AnthonyPapageo/Datalogger/README.md

# Datalogger
Datalogger with LCD interface

TFE Bachelier, c'était cool Thales !
