AnthonyPapageo/Datalogger/Eagle/DataloggerE7.brd

## EAGLE design Eagle/DataloggerE7.brd (2019-06-06)

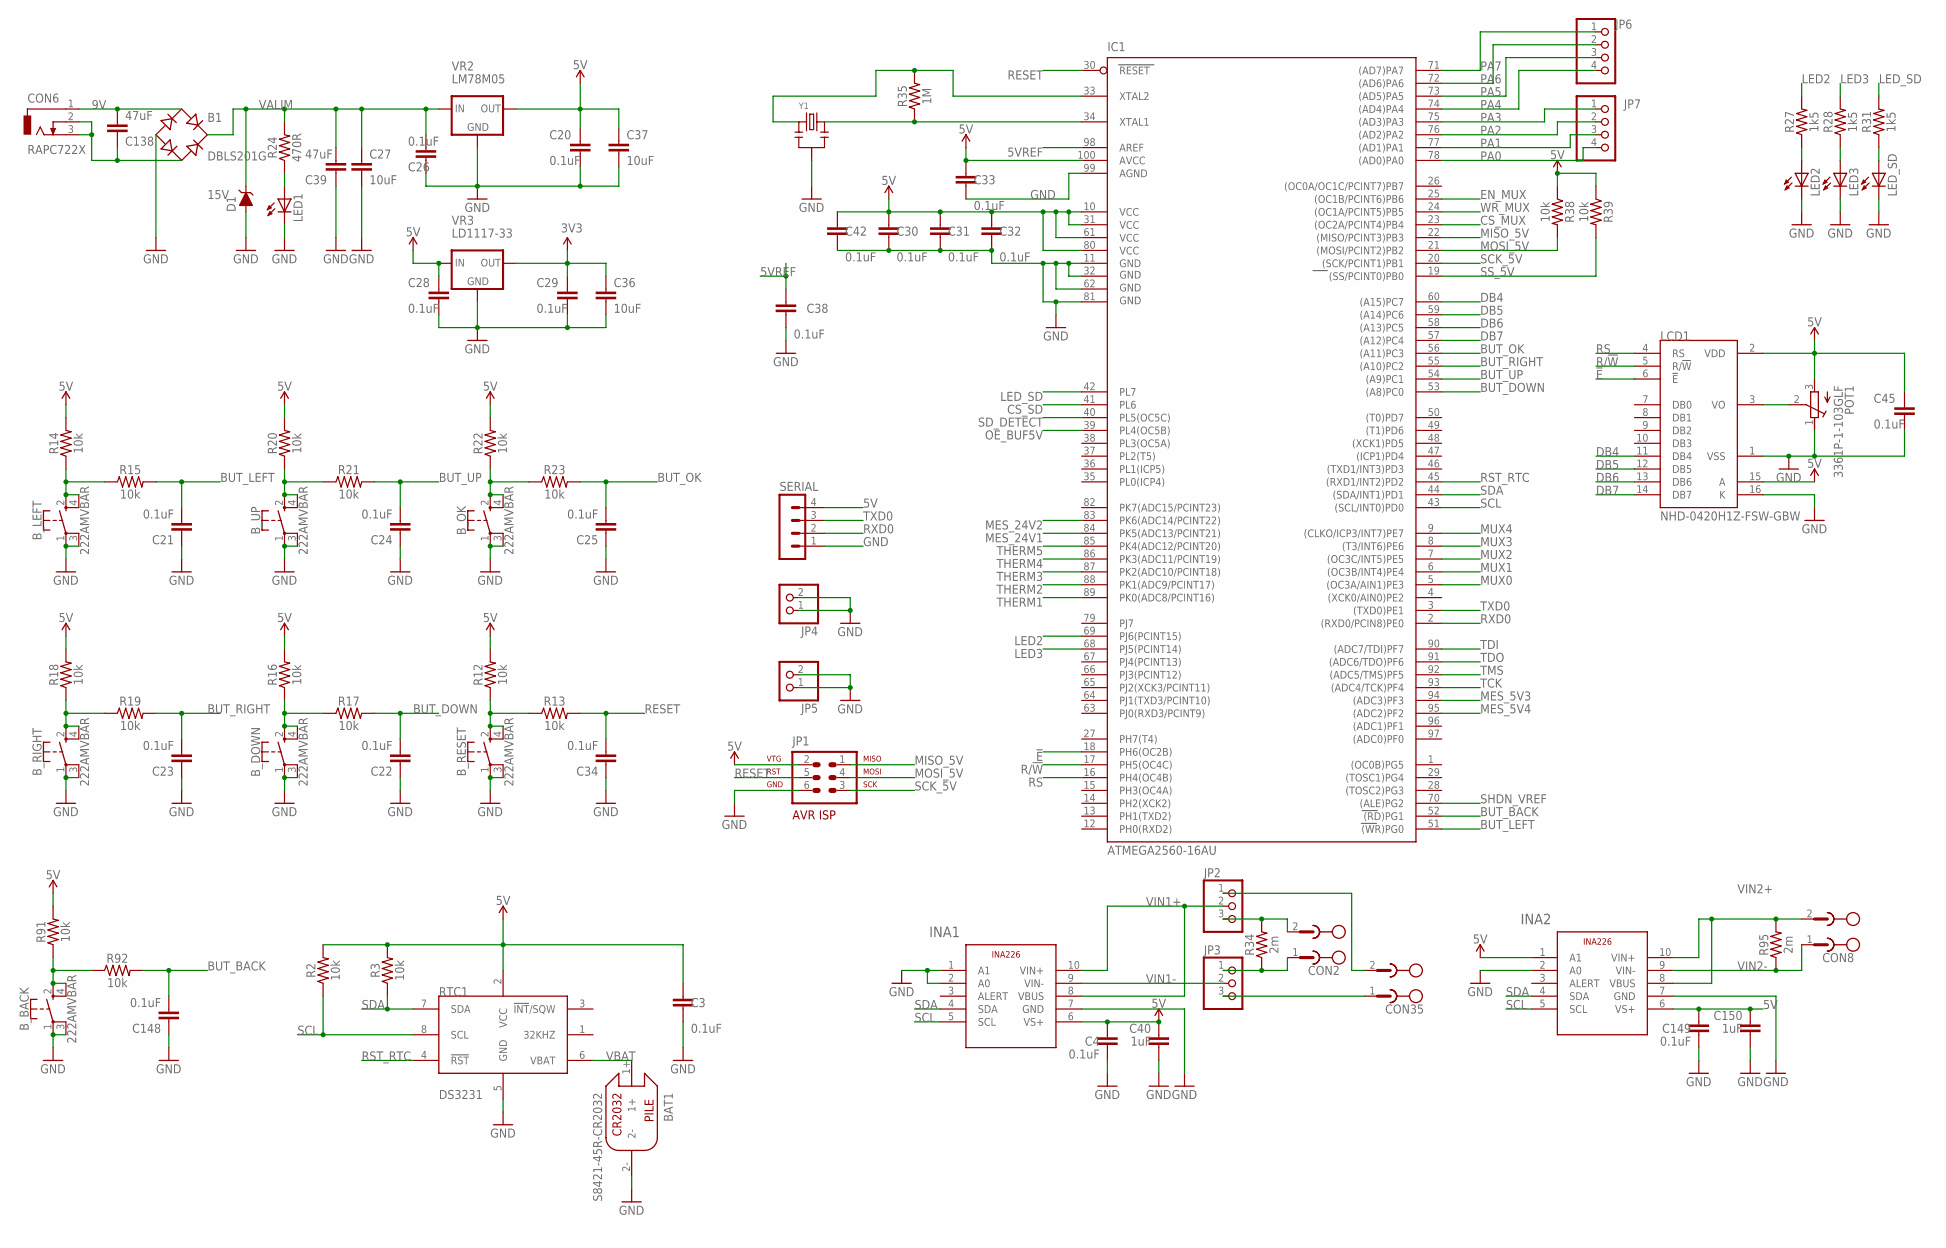
[picture p1: schematic DataloggerE7.sch, sheet 1]

Parts:
B1: DBLS201G; DBS
BAT1: S8421-45R-CR2032
B_BACK: 222AMVBAR; 222AMVBARSWITCH
B_DOWN: 222AMVBAR; 222AMVBARSWITCH
B_LEFT: 222AMVBAR; 222AMVBARSWITCH
B_OK: 222AMVBAR; 222AMVBARSWITCH
B_RESET: 222AMVBAR; 222AMVBARSWITCH
B_RIGHT: 222AMVBAR; 222AMVBARSWITCH
B_UP: 222AMVBAR; 222AMVBARSWITCH
C3, C4, C20, C21, C22, C23, C24, C25, C26, C28, C29, C30, C31, C32, C33, C34, C38, C42, C45, C148, C149: 0.1uF; 0603
C27, C36, C37: 10uF; 1206
C39, C138: 47uF; 1206
C40, C150: 1uF; 0603
CON2, CON8, CON35: CON_PHOENIX_508_2; MSTBV2
CON6: RAPC722X; JACK_RAPC722X
D1: DIODE-ZENER-MMSZ5232BS; SOD-323
IC1: ATMEGA2560-16AU; TQFP100
INA1, INA2: TI-INA226
JP1: AVR-ISP-6
JP2, JP3: PINHD-1X3; 1X03
JP4, JP5: PINHD-1X2; 1X02
JP6, JP7: PINHD-1X4; 1X04
LCD1: NHD-0420H1Z-FSW-GBW; LCD_2X8PINS
LED1, LED2, LED3: LEDSMT1206; 1206
LED_SD: LEDSMT1206; 1206
POT1: 3361P-1-103GLF; TRIMMER_BOURNS_SMD
R2, R3, R12, R13, R14, R15, R16, R17, R18, R19, R20, R21, R22, R23, R38, R39, R91, R92: 10k; 0603
R24: 470R; 1206
R27, R28, R31: 1k5; 0603
R34, R95: 2m; R2010
R35: 1M; 0603
RTC1: DS3231M; SOIC8
SERIAL: MA04-1
VR2: LM78M05; TO-252
VR3: LD1117-33; SOT223-THERMAL
Y1: CSTCE16M0V53-R0; CSTCE_V

Connections:
3V3: C29.1, C36.1, VR3.2 (OUT), VR3.4 (OUT); also elsewhere on the board
5V: C3.1, C4.2, C20.1, C28.1, C30.1, C31.1, C32.1, C33.1, C37.1, C40.2, C42.1, C45.1, C149.2, C150.2, IC1.10 (VCC), IC1.31 (VCC1), IC1.61 (VCC2), IC1.80 (VCC3), IC1.100 (AVCC), INA1.6 (VS+), INA2.1 (A1), INA2.6 (VS+), JP1.2, LCD1.2 (VDD), LCD1.15 (A), POT1.3 (A), R2.2, R3.2, R12.2, R14.2, R16.2, R18.2, R20.2, R22.2, R38.1, R39.1, R91.2, RTC1.2 (VCC), SERIAL.4, VR2.2 (OUT), VR3.3 (IN); also elsewhere on the board
5VREF: C38.1, IC1.98 (AREF); also elsewhere on the board
9V: B1.AC1, C138.1, CON6.1
!E!: IC1.18 (PH6(OC2B)), LCD1.6 (!E)
BUT_BACK: C148.2, IC1.52 ((RD)PG1), R92.2
BUT_DOWN: C22.2, IC1.53 ((A8)PC0), R17.2
BUT_LEFT: C21.2, IC1.51 ((WR)PG0), R15.2
BUT_OK: C25.2, IC1.56 ((A11)PC3), R23.2
BUT_RIGHT: C23.2, IC1.55 ((A10)PC2), R19.2
BUT_UP: C24.2, IC1.54 ((A9)PC1), R21.2
CS_MUX: IC1.23 ((OC2A/PCINT4)PB4); also elsewhere on the board
CS_SD: IC1.41 (PL6); also elsewhere on the board
DB4: IC1.60 ((A15)PC7), LCD1.11 (DB4)
DB5: IC1.59 ((A14)PC6), LCD1.12 (DB5)
DB6: IC1.58 ((A13)PC5), LCD1.13 (DB6)
DB7: IC1.57 ((A12)PC4), LCD1.14 (DB7)
EN_MUX: IC1.25 ((OC1B/PCINT6)PB6); also elsewhere on the board
GND: B1.-, BAT1.2-, B_BACK.1, B_BACK.3 (2), B_DOWN.1, B_DOWN.3 (2), B_LEFT.1, B_LEFT.3 (2), B_OK.1, B_OK.3 (2), B_RESET.1, B_RESET.3 (2), B_RIGHT.1, B_RIGHT.3 (2), B_UP.1, B_UP.3 (2), C3.2, C4.1, C20.2, C21.1, C22.1, C23.1, C24.1, C25.1, C26.2, C27.2, C28.2, C29.2, C30.2, C31.2, C32.2, C33.2, C34.1, C36.2, C37.2, C38.2, C39.2, C40.1, C42.2, C45.2, C148.1, C149.1, C150.1, D1.A, IC1.11 (GND), IC1.32 (GND1), IC1.62 (GND2), IC1.81 (GND3), IC1.99 (AGND), INA1.1 (A1), INA1.2 (A0), INA1.7 (GND), INA2.2 (A0), INA2.7 (GND), JP1.6, JP4.1, JP4.2, JP5.1, JP5.2, LCD1.1 (VSS), LCD1.16 (K), LED1.C, LED2.C, LED3.C, LED_SD.C, POT1.1 (E), RTC1.5 (GND), SERIAL.1, VR2.3 (GND), VR3.1 (GND), Y1.2 (GND); also elsewhere on the board
LED2: IC1.69 (PJ6(PCINT15)), R27.2
LED3: IC1.68 (PJ5(PCINT14)), R28.2
LED_SD: IC1.42 (PL7), R31.2
MES_5V3: IC1.94 ((ADC3)PF3); also elsewhere on the board
MES_5V4: IC1.95 ((ADC2)PF2); also elsewhere on the board
MES_24V1: IC1.84 (PK5(ADC13/PCINT21)); also elsewhere on the board
MES_24V2: IC1.83 (PK6(ADC14/PCINT22)); also elsewhere on the board
MISO_5V: IC1.22 ((MISO/PCINT3)PB3), JP1.1; also elsewhere on the board
MOSI_5V: IC1.21 ((MOSI/PCINT2)PB2), JP1.4, R38.2; also elsewhere on the board
MUX0: IC1.5 ((OC3A/AIN1)PE3); also elsewhere on the board
MUX1: IC1.6 ((OC3B/INT4)PE4); also elsewhere on the board
MUX2: IC1.7 ((OC3C/INT5)PE5); also elsewhere on the board
MUX3: IC1.8 ((T3/INT6)PE6); also elsewhere on the board
MUX4: IC1.9 ((CLKO/ICP3/INT7)PE7); also elsewhere on the board
unnamed: B1.AC2, C138.2, CON6.2, CON6.3
unnamed: B_LEFT.2 (3), B_LEFT.4, R14.1, R15.1
unnamed: B_DOWN.2 (3), B_DOWN.4, R16.1, R17.1
unnamed: B_RIGHT.2 (3), B_RIGHT.4, R18.1, R19.1
unnamed: B_UP.2 (3), B_UP.4, R20.1, R21.1
unnamed: B_OK.2 (3), B_OK.4, R22.1, R23.1
unnamed: B_RESET.2 (3), B_RESET.4, R12.1, R13.1
unnamed: LED1.A, R24.1
unnamed: LCD1.3 (VO), POT1.2 (S)
unnamed: LED_SD.A, R31.1
unnamed: LED2.A, R27.1
unnamed: CON2.1, JP3.1, R34.1
unnamed: CON2.2, JP2.3, R34.2
unnamed: CON35.2, JP2.1
unnamed: CON35.1, JP3.3
unnamed: LED3.A, R28.1
unnamed: B_BACK.2 (3), B_BACK.4, R91.1, R92.1
OE_BUF5V: IC1.39 (PL4(OC5B)); also elsewhere on the board
PA0: IC1.78 ((AD0)PA0), JP7.4
PA1: IC1.77 ((AD1)PA1), JP7.3
PA2: IC1.76 ((AD2)PA2), JP7.2
PA3: IC1.75 ((AD3)PA3), JP7.1
PA4: IC1.74 ((AD4)PA4), JP6.4
PA5: IC1.73 ((AD5)PA5), JP6.3
PA6: IC1.72 ((AD6)PA6), JP6.2
PA7: IC1.71 ((AD7)PA7), JP6.1
R/!W!: IC1.17 (PH5(OC4C)), LCD1.5 (R/!W)
RESET: C34.2, IC1.30 (RESET), JP1.5, R13.2; also elsewhere on the board
RS: IC1.16 (PH4(OC4B)), LCD1.4 (RS)
RST_RTC: IC1.45 ((RXD1/INT2)PD2), RTC1.4 (!RST!)
RXD0: IC1.2 ((RXD0/PCIN8)PE0), SERIAL.2
SCK_5V: IC1.20 ((SCK/PCINT1)PB1), JP1.3; also elsewhere on the board
SCL: IC1.43 ((SCL/INT0)PD0), INA1.5 (SCL), INA2.5 (SCL), R2.1, RTC1.8 (SCL)
SDA: IC1.44 ((SDA/INT1)PD1), INA1.4 (SDA), INA2.4 (SDA), R3.1, RTC1.7 (SDA)
SD_DETECT: IC1.40 (PL5(OC5C)); also elsewhere on the board
SHDN_VREF: IC1.70 ((ALE)PG2); also elsewhere on the board
SS_5V: IC1.19 ((SS/PCINT0)PB0), R39.2; also elsewhere on the board
TCK: IC1.93 ((ADC4/TCK)PF4); also elsewhere on the board
TDI: IC1.90 ((ADC7/TDI)PF7); also elsewhere on the board
TDO: IC1.91 ((ADC6/TDO)PF6); also elsewhere on the board
THERM1: IC1.89 (PK0(ADC8/PCINT16)); also elsewhere on the board
THERM2: IC1.88 (PK1(ADC9/PCINT17)); also elsewhere on the board
THERM3: IC1.87 (PK2(ADC10/PCINT18)); also elsewhere on the board
THERM4: IC1.86 (PK3(ADC11/PCINT19)); also elsewhere on the board
THERM5: IC1.85 (PK4(ADC12/PCINT20)); also elsewhere on the board
TMS: IC1.92 ((ADC5/TMS)PF5); also elsewhere on the board
TXD0: IC1.3 ((TXD0)PE1), SERIAL.3
VALIM: B1.+, C26.1, C27.1, C39.1, D1.C, R24.2, VR2.1 (IN); also elsewhere on the board
VBAT: BAT1.1+, RTC1.6 (VBAT)
VIN1+: INA1.8 (VBUS), INA1.10 (VIN+), JP2.2
VIN1-: INA1.9 (VIN-), JP3.2
VIN2+: CON8.2, INA2.8 (VBUS), INA2.10 (VIN+), R95.2
VIN2-: CON8.1, INA2.9 (VIN-), R95.1
WR_MUX: IC1.24 ((OC1A/PCINT5)PB5); also elsewhere on the board
XTAL1: IC1.34 (XTAL1), R35.1, Y1.3
XTAL2: IC1.33 (XTAL2), R35.2, Y1.1

Notes on the sheet:
15V

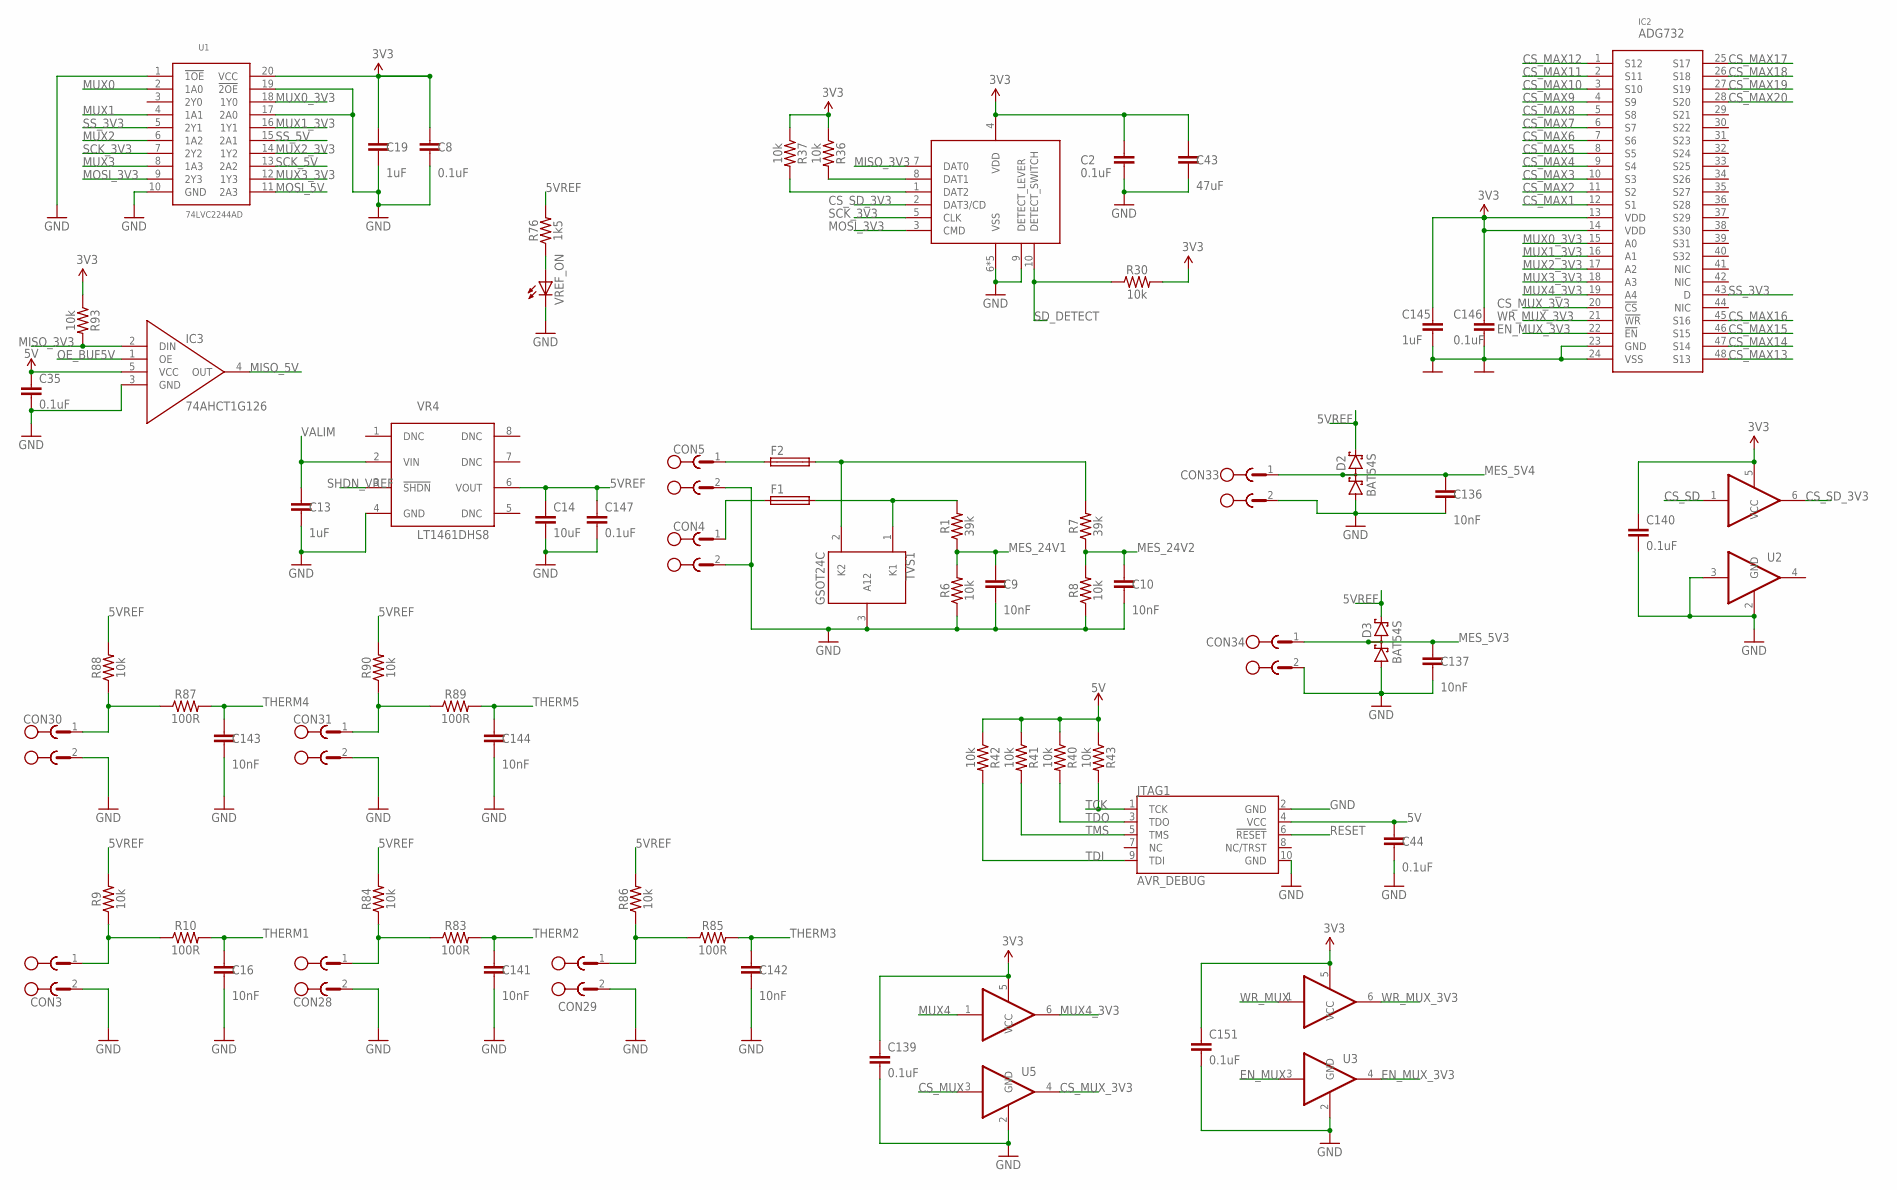
[picture p2: schematic DataloggerE7.sch, sheet 2]

Parts:
C2, C8, C35, C44, C139, C140, C146, C147, C151: 0.1uF; 0603
C9, C10, C16, C136, C137, C141, C142, C143, C144: 10nF; 0603
C13, C19, C145: 1uF; 0603
C14: 10uF; 1206
C43: 47uF; 1206
CON3, CON4, CON5, CON28, CON29, CON30, CON31, CON33, CON34: CON_PHOENIX_508_2; MSTBV2
CON7: MOLEX_5033981892; CONNECTOR_SDCARD_5033981892
D2, D3: BAT54S; SOT23
F1, F2: 0ZCJ0005FF2E; 0ZCJ_SERIES
IC2: ADG732; QFP50P900X900X105-48
IC3: 74AHCT1G126; SOT353
JTAG1: AVR_DEBUG; 2X5-PTH-1.27MM
R1, R7: 39k; 0603
R6, R8, R9, R30, R36, R37, R40, R41, R42, R43, R84, R86, R88, R90, R93: 10k; 0603
R10, R83, R85, R87, R89: 100R; 0603
R76: 1k5; 0603
TVS1: GSOT24C; SOT23_3PAD
U1: 74LVC2244AD; SOIC20
U2, U3, U5: 74LVC2G17SOT363; SOT363
VR4: LT1461DHS8; SOIC8-LT1461
VREF_ON: LEDSMT1206; 1206

Connections:
3V3: C2.1, C8.1, C19.1, C43.1, C139.1, C140.1, C145.1, C146.1, C151.1, CON7.4 (VDD), IC2.13 (VDD), IC2.14 (VDD), R30.2, R36.1, R37.1, R93.1, U1.20 (VCC), U2.5 (VCC), U3.5 (VCC), U5.5 (VCC); also elsewhere on the board
5V: C35.1, C44.1, IC3.5 (VCC), JTAG1.4 (VCC), R40.1, R41.1, R42.1, R43.1; also elsewhere on the board
5VREF: C14.1, C147.1, D2.2 (C2), D3.2 (C2), R9.2, R76.2, R84.2, R86.2, R88.2, R90.2, VR4.6 (VOUT); also elsewhere on the board
CS_MAX1: IC2.12 (S1); also elsewhere on the board
CS_MAX2: IC2.11 (S2); also elsewhere on the board
CS_MAX3: IC2.10 (S3); also elsewhere on the board
CS_MAX4: IC2.9 (S4); also elsewhere on the board
CS_MAX5: IC2.8 (S5); also elsewhere on the board
CS_MAX6: IC2.7 (S6); also elsewhere on the board
CS_MAX7: IC2.6 (S7); also elsewhere on the board
CS_MAX8: IC2.5 (S8); also elsewhere on the board
CS_MAX9: IC2.4 (S9); also elsewhere on the board
CS_MAX10: IC2.3 (S10); also elsewhere on the board
CS_MAX11: IC2.2 (S11); also elsewhere on the board
CS_MAX12: IC2.1 (S12); also elsewhere on the board
CS_MAX13: IC2.48 (S13); also elsewhere on the board
CS_MAX14: IC2.47 (S14); also elsewhere on the board
CS_MAX15: IC2.46 (S15); also elsewhere on the board
CS_MAX16: IC2.45 (S16); also elsewhere on the board
CS_MAX17: IC2.25 (S17); also elsewhere on the board
CS_MAX18: IC2.26 (S18); also elsewhere on the board
CS_MAX19: IC2.27 (S19); also elsewhere on the board
CS_MAX20: IC2.28 (S20); also elsewhere on the board
CS_MUX: U5.3 (I1); also elsewhere on the board
CS_MUX_3V3: IC2.20 (!CS), U5.4 (O1)
CS_SD: U2.1 (I); also elsewhere on the board
CS_SD_3V3: CON7.2 (DAT3/CD), U2.6 (O)
EN_MUX: U3.3 (I1); also elsewhere on the board
EN_MUX_3V3: IC2.22 (!EN), U3.4 (O1)
GND: C2.2, C8.2, C9.2, C10.2, C13.2, C14.2, C16.2, C19.2, C35.2, C43.2, C44.2, C136.2, C137.2, C139.2, C140.2, C141.2, C142.2, C143.2, C144.2, C145.2, C146.2, C147.2, C151.2, CON3.2, CON4.2, CON5.2, CON7.6 (VSS), CON7.9 (DETECT_LEVER), CON7.11 (VSS), CON7.12 (VSS), CON7.13 (VSS), CON7.14 (VSS), CON28.2, CON29.2, CON30.2, CON31.2, CON33.2, CON34.2, D2.1 (A1), D3.1 (A1), IC2.23 (GND), IC2.24 (VSS), IC3.3 (GND), JTAG1.2 (GND), JTAG1.10 (GND), R6.1, R8.1, TVS1.3 (A12), U1.1 (!1OE!), U1.10 (GND), U1.17 (2A0), U1.19 (!2OE!), U2.2 (GND), U2.3 (I1), U3.2 (GND), U5.2 (GND), VR4.4 (GND), VREF_ON.C; also elsewhere on the board
MES_5V3: C137.1, CON34.1, D3.3 (C1A2); also elsewhere on the board
MES_5V4: C136.1, CON33.1, D2.3 (C1A2); also elsewhere on the board
MES_24V1: C9.1, R1.1, R6.2; also elsewhere on the board
MES_24V2: C10.1, R7.1, R8.2; also elsewhere on the board
MISO_3V3: CON7.7 (DAT0), IC3.2 (DIN), R93.2; also elsewhere on the board
MISO_5V: IC3.4 (OUT); also elsewhere on the board
MOSI_3V3: CON7.3 (CMD), U1.9 (2Y3); also elsewhere on the board
MOSI_5V: U1.11 (2A3); also elsewhere on the board
MUX0: U1.2 (1A0); also elsewhere on the board
MUX0_3V3: IC2.15 (A0), U1.18 (1Y0)
MUX1: U1.4 (1A1); also elsewhere on the board
MUX1_3V3: IC2.16 (A1), U1.16 (1Y1)
MUX2: U1.6 (1A2); also elsewhere on the board
MUX2_3V3: IC2.17 (A2), U1.14 (1Y2)
MUX3: U1.8 (1A3); also elsewhere on the board
MUX3_3V3: IC2.18 (A3), U1.12 (1Y3)
MUX4: U5.1 (I); also elsewhere on the board
MUX4_3V3: IC2.19 (A4), U5.6 (O)
unnamed: F2.2, R7.2, TVS1.2 (K2)
unnamed: CON7.8 (DAT1), R36.2
unnamed: CON7.1 (DAT2), R37.2
unnamed: CON3.1, R9.1, R10.1
unnamed: F1.2, R1.2, TVS1.1 (K1)
unnamed: CON5.1, F2.1
unnamed: CON30.1, R87.1, R88.1
unnamed: CON29.1, R85.1, R86.1
unnamed: CON4.1, F1.1
unnamed: CON28.1, R83.1, R84.1
unnamed: R76.1, VREF_ON.A
unnamed: CON31.1, R89.1, R90.1
OE_BUF5V: IC3.1 (OE); also elsewhere on the board
RESET: JTAG1.6 (!RESET!); also elsewhere on the board
SCK_3V3: CON7.5 (CLK), U1.7 (2Y2); also elsewhere on the board
SCK_5V: U1.13 (2A2); also elsewhere on the board
SD_DETECT: CON7.10 (DETECT_SWITCH), R30.1; also elsewhere on the board
SHDN_VREF: VR4.3 (!SHDN!); also elsewhere on the board
SS_3V3: IC2.43 (D), U1.5 (2Y1)
SS_5V: U1.15 (2A1); also elsewhere on the board
TCK: JTAG1.1 (TCK), R43.2; also elsewhere on the board
TDI: JTAG1.9 (TDI), R42.2; also elsewhere on the board
TDO: JTAG1.3 (TDO), R40.2; also elsewhere on the board
THERM1: C16.1, R10.2; also elsewhere on the board
THERM2: C141.1, R83.2; also elsewhere on the board
THERM3: C142.1, R85.2; also elsewhere on the board
THERM4: C143.1, R87.2; also elsewhere on the board
THERM5: C144.1, R89.2; also elsewhere on the board
TMS: JTAG1.5 (TMS), R41.2; also elsewhere on the board
VALIM: C13.1, VR4.2 (VIN); also elsewhere on the board
WR_MUX: U3.1 (I); also elsewhere on the board
WR_MUX_3V3: IC2.21 (!WR), U3.6 (O)

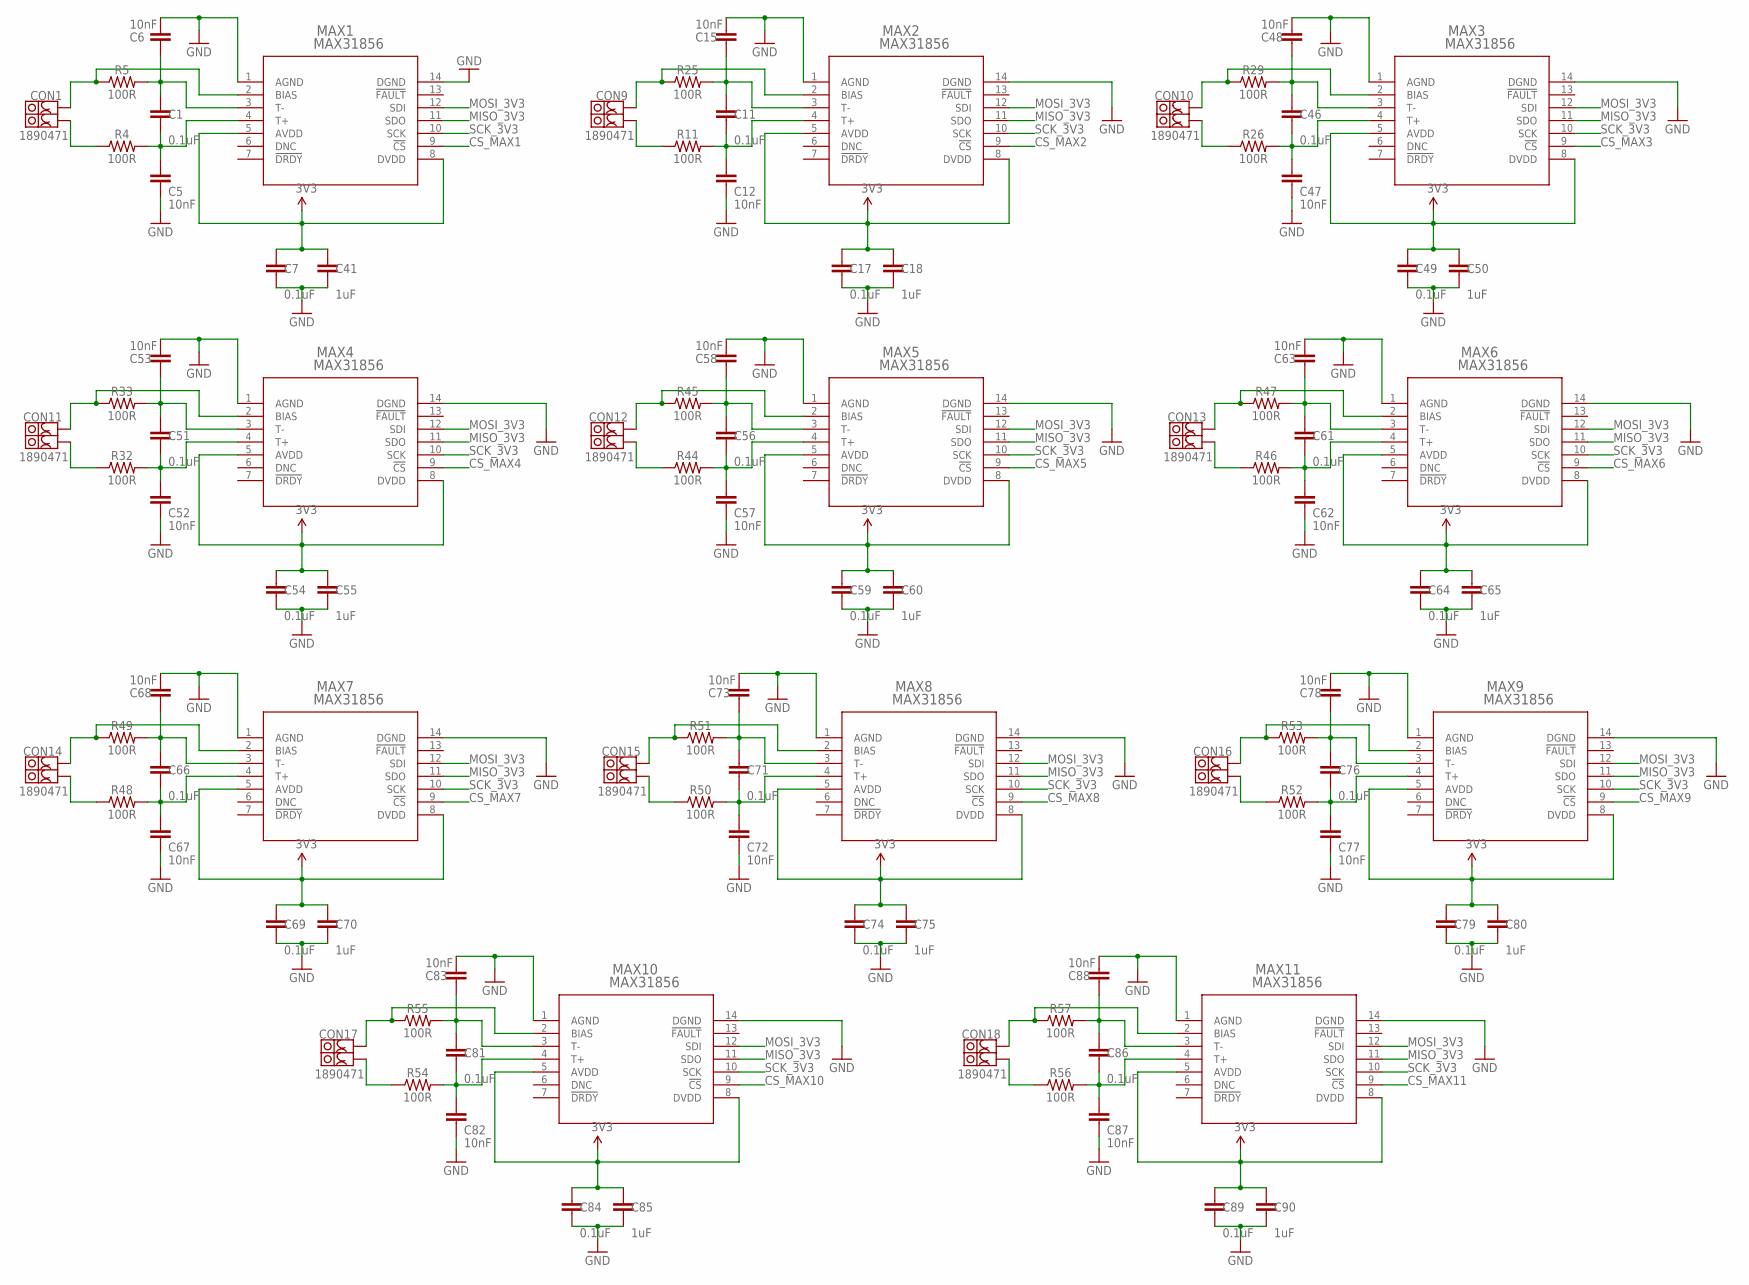
[picture p3: schematic DataloggerE7.sch, sheet 3]

Parts:
C1, C7, C11, C17, C46, C49, C51, C54, C56, C59, C61, C64, C66, C69, C71, C74, C76, C79, C81, C84, C86, C89: 0.1uF; 0603
C5, C6, C12, C15, C47, C48, C52, C53, C57, C58, C62, C63, C67, C68, C72, C73, C77, C78, C82, C83, C87, C88: 10nF; 0603
C18, C41, C50, C55, C60, C65, C70, C75, C80, C85, C90: 1uF; 0603
CON1, CON9, CON10, CON11, CON12, CON13, CON14, CON15, CON16, CON17, CON18: 1890471
MAX1, MAX2, MAX3, MAX4, MAX5, MAX6, MAX7, MAX8, MAX9, MAX10, MAX11: MAX31856; 21-066J-14-M
R4, R5, R11, R25, R26, R29, R32, R33, R44, R45, R46, R47, R48, R49, R50, R51, R52, R53, R54, R55, R56, R57: 100R; 0603

Connections:
3V3: C7.1, C17.1, C18.1, C41.1, C49.1, C50.1, C54.1, C55.1, C59.1, C60.1, C64.1, C65.1, C69.1, C70.1, C74.1, C75.1, C79.1, C80.1, C84.1, C85.1, C89.1, C90.1, MAX1.5 (AVDD), MAX1.8 (DVDD), MAX2.5 (AVDD), MAX2.8 (DVDD), MAX3.5 (AVDD), MAX3.8 (DVDD), MAX4.5 (AVDD), MAX4.8 (DVDD), MAX5.5 (AVDD), MAX5.8 (DVDD), MAX6.5 (AVDD), MAX6.8 (DVDD), MAX7.5 (AVDD), MAX7.8 (DVDD), MAX8.5 (AVDD), MAX8.8 (DVDD), MAX9.5 (AVDD), MAX9.8 (DVDD), MAX10.5 (AVDD), MAX10.8 (DVDD), MAX11.5 (AVDD), MAX11.8 (DVDD); also elsewhere on the board
BIAS: CON1.A (1A), CON1.B (1A), MAX1.2 (BIAS), R5.1
BIAS1: CON9.A (1A), CON9.B (1A), MAX2.2 (BIAS), R25.1
BIAS2: CON10.A (1A), CON10.B (1A), MAX3.2 (BIAS), R29.1
BIAS3: CON11.A (1A), CON11.B (1A), MAX4.2 (BIAS), R33.1
BIAS5: CON12.A (1A), CON12.B (1A), MAX5.2 (BIAS), R45.1
BIAS6: CON13.A (1A), CON13.B (1A), MAX6.2 (BIAS), R47.1
BIAS7: CON14.A (1A), CON14.B (1A), MAX7.2 (BIAS), R49.1
BIAS8: CON15.A (1A), CON15.B (1A), MAX8.2 (BIAS), R51.1
BIAS9: CON16.A (1A), CON16.B (1A), MAX9.2 (BIAS), R53.1
BIAS10: CON17.A (1A), CON17.B (1A), MAX10.2 (BIAS), R55.1
BIAS11: CON18.A (1A), CON18.B (1A), MAX11.2 (BIAS), R57.1
CS_MAX1: MAX1.9 (!CS); also elsewhere on the board
CS_MAX2: MAX2.9 (!CS); also elsewhere on the board
CS_MAX3: MAX3.9 (!CS); also elsewhere on the board
CS_MAX4: MAX4.9 (!CS); also elsewhere on the board
CS_MAX5: MAX5.9 (!CS); also elsewhere on the board
CS_MAX6: MAX6.9 (!CS); also elsewhere on the board
CS_MAX7: MAX7.9 (!CS); also elsewhere on the board
CS_MAX8: MAX8.9 (!CS); also elsewhere on the board
CS_MAX9: MAX9.9 (!CS); also elsewhere on the board
CS_MAX10: MAX10.9 (!CS); also elsewhere on the board
CS_MAX11: MAX11.9 (!CS); also elsewhere on the board
GND: C5.2, C6.1, C7.2, C12.2, C15.1, C17.2, C18.2, C41.2, C47.2, C48.1, C49.2, C50.2, C52.2, C53.1, C54.2, C55.2, C57.2, C58.1, C59.2, C60.2, C62.2, C63.1, C64.2, C65.2, C67.2, C68.1, C69.2, C70.2, C72.2, C73.1, C74.2, C75.2, C77.2, C78.1, C79.2, C80.2, C82.2, C83.1, C84.2, C85.2, C87.2, C88.1, C89.2, C90.2, MAX1.1 (AGND), MAX1.14 (DGND), MAX2.1 (AGND), MAX2.14 (DGND), MAX3.1 (AGND), MAX3.14 (DGND), MAX4.1 (AGND), MAX4.14 (DGND), MAX5.1 (AGND), MAX5.14 (DGND), MAX6.1 (AGND), MAX6.14 (DGND), MAX7.1 (AGND), MAX7.14 (DGND), MAX8.1 (AGND), MAX8.14 (DGND), MAX9.1 (AGND), MAX9.14 (DGND), MAX10.1 (AGND), MAX10.14 (DGND), MAX11.1 (AGND), MAX11.14 (DGND); also elsewhere on the board
MISO_3V3: MAX1.11 (SDO), MAX2.11 (SDO), MAX3.11 (SDO), MAX4.11 (SDO), MAX5.11 (SDO), MAX6.11 (SDO), MAX7.11 (SDO), MAX8.11 (SDO), MAX9.11 (SDO), MAX10.11 (SDO), MAX11.11 (SDO); also elsewhere on the board
MOSI_3V3: MAX1.12 (SDI), MAX2.12 (SDI), MAX3.12 (SDI), MAX4.12 (SDI), MAX5.12 (SDI), MAX6.12 (SDI), MAX7.12 (SDI), MAX8.12 (SDI), MAX9.12 (SDI), MAX10.12 (SDI), MAX11.12 (SDI); also elsewhere on the board
unnamed: CON1.A1 (1A1), CON1.B1 (1A1), R4.1
unnamed: CON9.A1 (1A1), CON9.B1 (1A1), R11.1
unnamed: CON10.A1 (1A1), CON10.B1 (1A1), R26.1
unnamed: CON11.A1 (1A1), CON11.B1 (1A1), R32.1
unnamed: CON12.A1 (1A1), CON12.B1 (1A1), R44.1
unnamed: CON13.A1 (1A1), CON13.B1 (1A1), R46.1
unnamed: CON14.A1 (1A1), CON14.B1 (1A1), R48.1
unnamed: CON15.A1 (1A1), CON15.B1 (1A1), R50.1
unnamed: CON16.A1 (1A1), CON16.B1 (1A1), R52.1
unnamed: CON17.A1 (1A1), CON17.B1 (1A1), R54.1
unnamed: CON18.A1 (1A1), CON18.B1 (1A1), R56.1
SCK_3V3: MAX1.10 (SCK), MAX2.10 (SCK), MAX3.10 (SCK), MAX4.10 (SCK), MAX5.10 (SCK), MAX6.10 (SCK), MAX7.10 (SCK), MAX8.10 (SCK), MAX9.10 (SCK), MAX10.10 (SCK), MAX11.10 (SCK); also elsewhere on the board
T+: C1.2, C5.1, MAX1.4 (T+), R4.2
T+1: C11.2, C12.1, MAX2.4 (T+), R11.2
T+2: C46.2, C47.1, MAX3.4 (T+), R26.2
T+3: C51.2, C52.1, MAX4.4 (T+), R32.2
T+5: C56.2, C57.1, MAX5.4 (T+), R44.2
T+6: C61.2, C62.1, MAX6.4 (T+), R46.2
T+7: C66.2, C67.1, MAX7.4 (T+), R48.2
T+8: C71.2, C72.1, MAX8.4 (T+), R50.2
T+9: C76.2, C77.1, MAX9.4 (T+), R52.2
T+10: C81.2, C82.1, MAX10.4 (T+), R54.2
T+11: C86.2, C87.1, MAX11.4 (T+), R56.2
T-: C1.1, C6.2, MAX1.3 (T-), R5.2
T-1: C11.1, C15.2, MAX2.3 (T-), R25.2
T-2: C46.1, C48.2, MAX3.3 (T-), R29.2
T-3: C51.1, C53.2, MAX4.3 (T-), R33.2
T-5: C56.1, C58.2, MAX5.3 (T-), R45.2
T-6: C61.1, C63.2, MAX6.3 (T-), R47.2
T-7: C66.1, C68.2, MAX7.3 (T-), R49.2
T-8: C71.1, C73.2, MAX8.3 (T-), R51.2
T-9: C76.1, C78.2, MAX9.3 (T-), R53.2
T-10: C81.1, C83.2, MAX10.3 (T-), R55.2
T-11: C86.1, C88.2, MAX11.3 (T-), R57.2

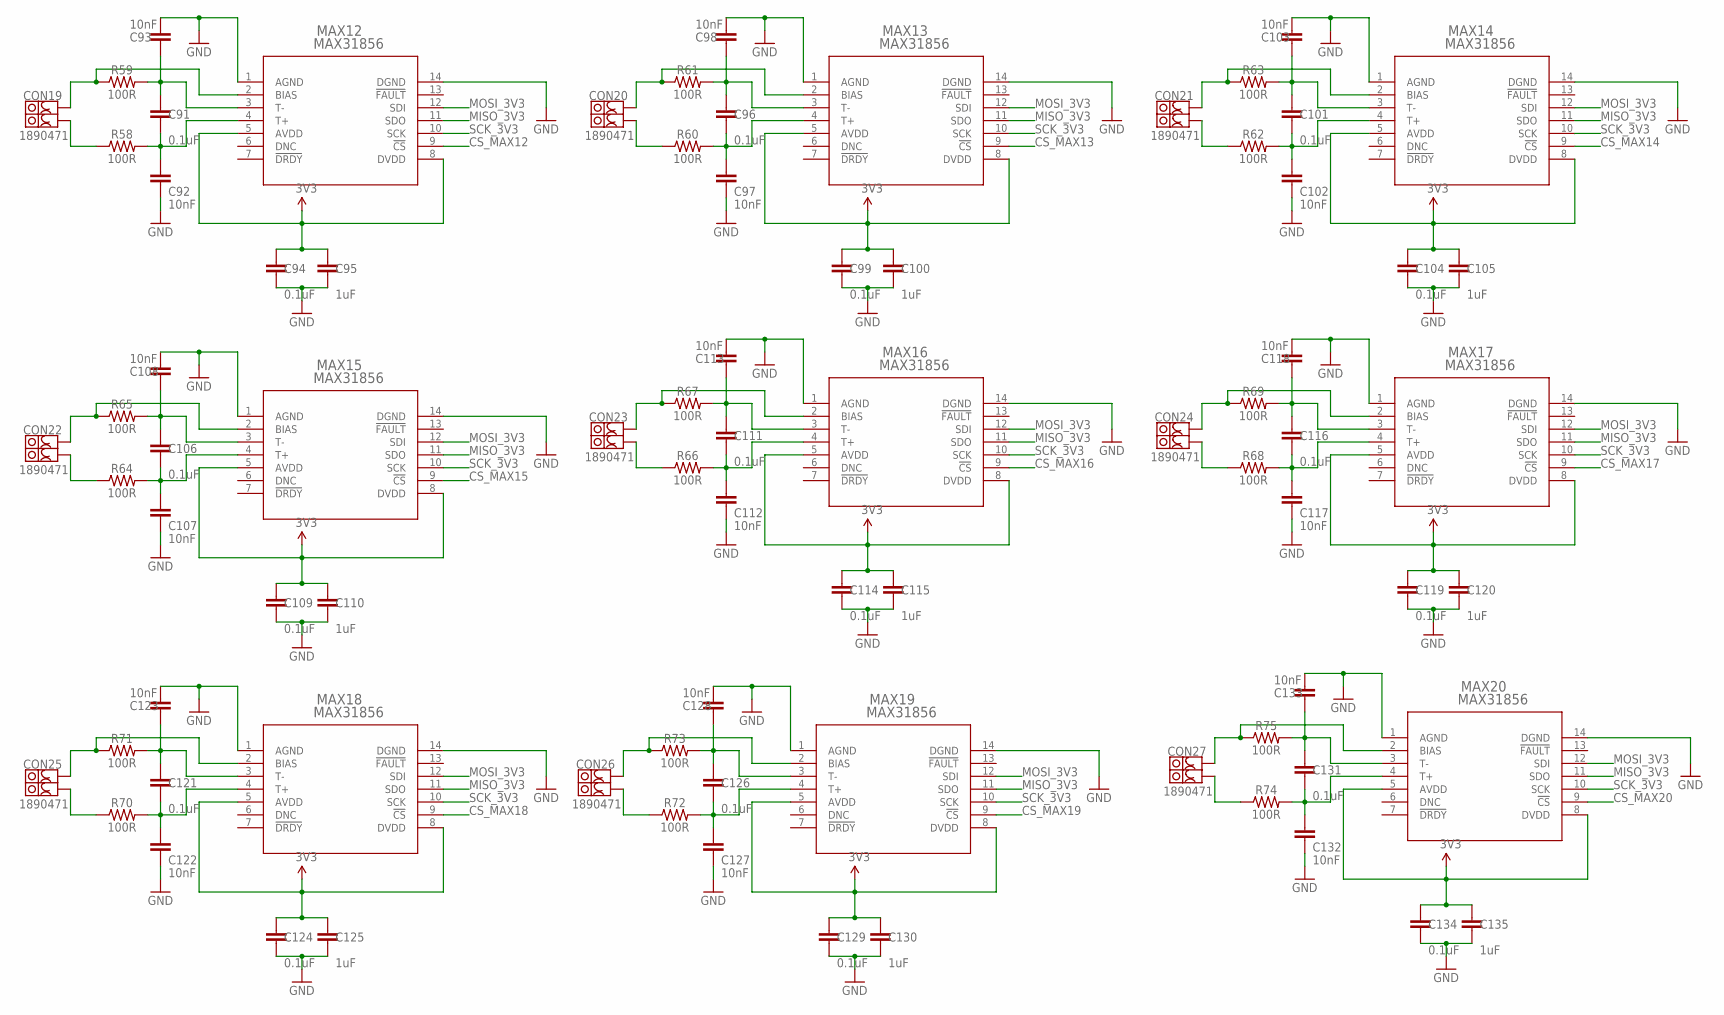
[picture p4: schematic DataloggerE7.sch, sheet 4]

Parts:
C91, C94, C96, C99, C101, C104, C106, C109, C111, C114, C116, C119, C121, C124, C126, C129, C131, C134: 0.1uF; 0603
C92, C93, C97, C98, C102, C103, C107, C108, C112, C113, C117, C118, C122, C123, C127, C128, C132, C133: 10nF; 0603
C95, C100, C105, C110, C115, C120, C125, C130, C135: 1uF; 0603
CON19, CON20, CON21, CON22, CON23, CON24, CON25, CON26, CON27: 1890471
MAX12, MAX13, MAX14, MAX15, MAX16, MAX17, MAX18, MAX19, MAX20: MAX31856; 21-066J-14-M
R58, R59, R60, R61, R62, R63, R64, R65, R66, R67, R68, R69, R70, R71, R72, R73, R74, R75: 100R; 0603

Connections:
3V3: C94.1, C95.1, C99.1, C100.1, C104.1, C105.1, C109.1, C110.1, C114.1, C115.1, C119.1, C120.1, C124.1, C125.1, C129.1, C130.1, C134.1, C135.1, MAX12.5 (AVDD), MAX12.8 (DVDD), MAX13.5 (AVDD), MAX13.8 (DVDD), MAX14.5 (AVDD), MAX14.8 (DVDD), MAX15.5 (AVDD), MAX15.8 (DVDD), MAX16.5 (AVDD), MAX16.8 (DVDD), MAX17.5 (AVDD), MAX17.8 (DVDD), MAX18.5 (AVDD), MAX18.8 (DVDD), MAX19.5 (AVDD), MAX19.8 (DVDD), MAX20.5 (AVDD), MAX20.8 (DVDD); also elsewhere on the board
BIAS4: CON19.A (1A), CON19.B (1A), MAX12.2 (BIAS), R59.1
BIAS12: CON20.A (1A), CON20.B (1A), MAX13.2 (BIAS), R61.1
BIAS13: CON21.A (1A), CON21.B (1A), MAX14.2 (BIAS), R63.1
BIAS14: CON22.A (1A), CON22.B (1A), MAX15.2 (BIAS), R65.1
BIAS15: CON23.A (1A), CON23.B (1A), MAX16.2 (BIAS), R67.1
BIAS16: CON24.A (1A), CON24.B (1A), MAX17.2 (BIAS), R69.1
BIAS17: CON25.A (1A), CON25.B (1A), MAX18.2 (BIAS), R71.1
BIAS18: CON26.A (1A), CON26.B (1A), MAX19.2 (BIAS), R73.1
BIAS19: CON27.A (1A), CON27.B (1A), MAX20.2 (BIAS), R75.1
CS_MAX12: MAX12.9 (!CS); also elsewhere on the board
CS_MAX13: MAX13.9 (!CS); also elsewhere on the board
CS_MAX14: MAX14.9 (!CS); also elsewhere on the board
CS_MAX15: MAX15.9 (!CS); also elsewhere on the board
CS_MAX16: MAX16.9 (!CS); also elsewhere on the board
CS_MAX17: MAX17.9 (!CS); also elsewhere on the board
CS_MAX18: MAX18.9 (!CS); also elsewhere on the board
CS_MAX19: MAX19.9 (!CS); also elsewhere on the board
CS_MAX20: MAX20.9 (!CS); also elsewhere on the board
GND: C92.2, C93.1, C94.2, C95.2, C97.2, C98.1, C99.2, C100.2, C102.2, C103.1, C104.2, C105.2, C107.2, C108.1, C109.2, C110.2, C112.2, C113.1, C114.2, C115.2, C117.2, C118.1, C119.2, C120.2, C122.2, C123.1, C124.2, C125.2, C127.2, C128.1, C129.2, C130.2, C132.2, C133.1, C134.2, C135.2, MAX12.1 (AGND), MAX12.14 (DGND), MAX13.1 (AGND), MAX13.14 (DGND), MAX14.1 (AGND), MAX14.14 (DGND), MAX15.1 (AGND), MAX15.14 (DGND), MAX16.1 (AGND), MAX16.14 (DGND), MAX17.1 (AGND), MAX17.14 (DGND), MAX18.1 (AGND), MAX18.14 (DGND), MAX19.1 (AGND), MAX19.14 (DGND), MAX20.1 (AGND), MAX20.14 (DGND); also elsewhere on the board
MISO_3V3: MAX12.11 (SDO), MAX13.11 (SDO), MAX14.11 (SDO), MAX15.11 (SDO), MAX16.11 (SDO), MAX17.11 (SDO), MAX18.11 (SDO), MAX19.11 (SDO), MAX20.11 (SDO); also elsewhere on the board
MOSI_3V3: MAX12.12 (SDI), MAX13.12 (SDI), MAX14.12 (SDI), MAX15.12 (SDI), MAX16.12 (SDI), MAX17.12 (SDI), MAX18.12 (SDI), MAX19.12 (SDI), MAX20.12 (SDI); also elsewhere on the board
unnamed: CON20.A1 (1A1), CON20.B1 (1A1), R60.1
unnamed: CON21.A1 (1A1), CON21.B1 (1A1), R62.1
unnamed: CON19.A1 (1A1), CON19.B1 (1A1), R58.1
unnamed: CON22.A1 (1A1), CON22.B1 (1A1), R64.1
unnamed: CON23.A1 (1A1), CON23.B1 (1A1), R66.1
unnamed: CON24.A1 (1A1), CON24.B1 (1A1), R68.1
unnamed: CON25.A1 (1A1), CON25.B1 (1A1), R70.1
unnamed: CON26.A1 (1A1), CON26.B1 (1A1), R72.1
unnamed: CON27.A1 (1A1), CON27.B1 (1A1), R74.1
SCK_3V3: MAX12.10 (SCK), MAX13.10 (SCK), MAX14.10 (SCK), MAX15.10 (SCK), MAX16.10 (SCK), MAX17.10 (SCK), MAX18.10 (SCK), MAX19.10 (SCK), MAX20.10 (SCK); also elsewhere on the board
T+4: C91.2, C92.1, MAX12.4 (T+), R58.2
T+12: C96.2, C97.1, MAX13.4 (T+), R60.2
T+13: C101.2, C102.1, MAX14.4 (T+), R62.2
T+14: C106.2, C107.1, MAX15.4 (T+), R64.2
T+15: C111.2, C112.1, MAX16.4 (T+), R66.2
T+16: C116.2, C117.1, MAX17.4 (T+), R68.2
T+17: C121.2, C122.1, MAX18.4 (T+), R70.2
T+18: C126.2, C127.1, MAX19.4 (T+), R72.2
T+19: C131.2, C132.1, MAX20.4 (T+), R74.2
T-4: C91.1, C93.2, MAX12.3 (T-), R59.2
T-12: C96.1, C98.2, MAX13.3 (T-), R61.2
T-13: C101.1, C103.2, MAX14.3 (T-), R63.2
T-14: C106.1, C108.2, MAX15.3 (T-), R65.2
T-15: C111.1, C113.2, MAX16.3 (T-), R67.2
T-16: C116.1, C118.2, MAX17.3 (T-), R69.2
T-17: C121.1, C123.2, MAX18.3 (T-), R71.2
T-18: C126.1, C128.2, MAX19.3 (T-), R73.2
T-19: C131.1, C133.2, MAX20.3 (T-), R75.2
