AnthonyPapageo/Datalogger/Eagle/DataloggerE7.brd

## EAGLE design Eagle/DataloggerE7.brd (continued)

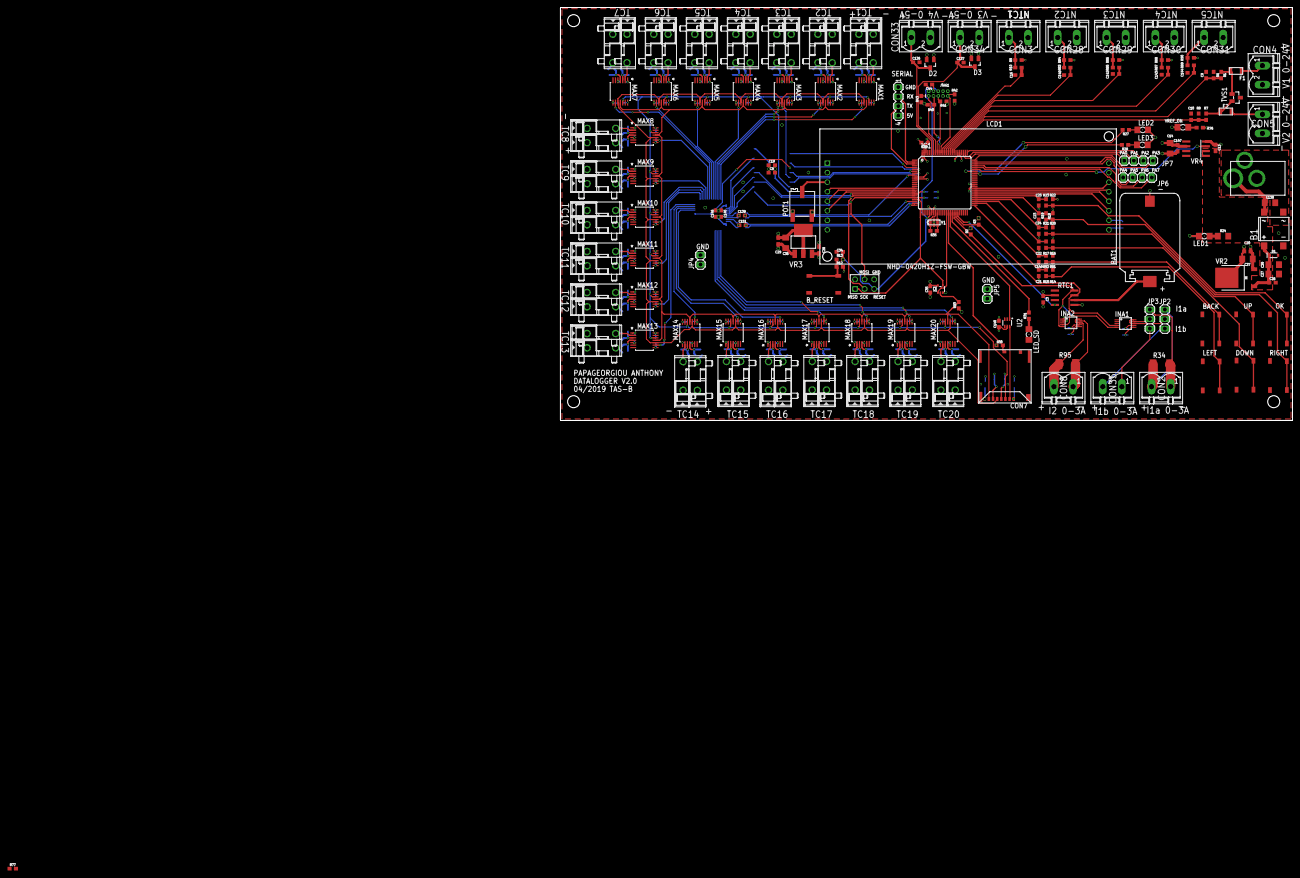
[picture p5: board DataloggerE7.brd from above]

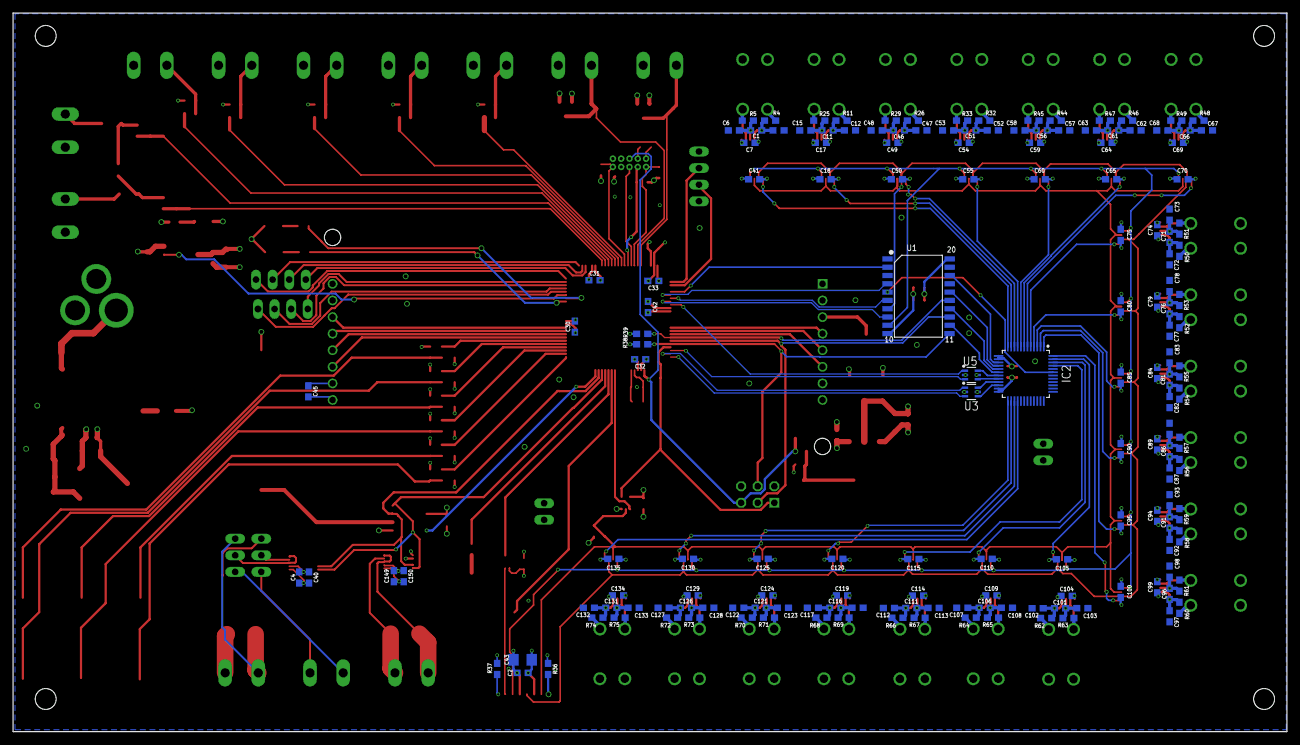
[picture p6: board DataloggerE7.brd from below]

Board: 4 copper layers, 195.0 x 110.0 mm, 339 parts (160 on the bottom side), 214 nets.

Other parts of the board:
R77: 10k; 0603

Their connections:
3V3: R77.1; also elsewhere on the board
CS_MAX1: R77.2; also elsewhere on the board
