AnthonyPapageo/Datalogger/MAX31856.cpp

/*!
* @file MAX31856.cpp
*
*
*/

#include "MAX31856.h"
#ifdef __AVR
#include <avr/pgmspace.h>
#include <util/delay.h>
#elif defined(ESP8266)
#include <pgmspace.h>
#endif

#include <stdlib.h>
#include <SPI.h>
#include <stdint.h>
#include "utility.h"
#include "global.h"



//WARNING CPHA = 1 is MANDATORY
static SPISettings max31856_spisettings = SPISettings(400000, MSBFIRST, SPI_MODE1);



/**************************************************************************/
/*!
@brief  Instantiate MAX31856 object and use hardware SPI
@param  mux_channel for multiplexer channel
*/
/**************************************************************************/
MAX31856::MAX31856(int8_t mux_channel) {

	_muxChannel = mux_channel;
}

void MAX31856::begin(void)
{
	SPI.begin();
	// assert on any fault
	writeRegister8(MAX31856_MASK_REG, 0x0);
	writeRegister8(MAX31856_CR0_REG, MAX31856_CR0_OCFAULT0);//Set open detection fault
	setThermocoupleType(MAX31856_TCTYPE_T); //At default we set at type T TC
	setNoiseFilter(MAX31856_NOISE_FILTER_50HZ); //Filter 50Hz
}



/**************************************************************************/
/*!
@brief  Set which kind of Thermocouple (K, J, T, etc) to detect & decode
@param type The enumeration type of the thermocouple
*/
/**************************************************************************/
void MAX31856::setThermocoupleType(max31856_thermocoupletype_t type) {
	uint8_t t = readRegister8(MAX31856_CR1_REG);
	t &= 0xF0; // mask off bottom 4 bits
	t |= (uint8_t)type & 0x0F;
	writeRegister8(MAX31856_CR1_REG, t);
}

/**************************************************************************/
/*!
@brief  Get which kind of Thermocouple (K, J, T, etc) we are using
@returns The enumeration type of the thermocouple
*/
/**************************************************************************/
max31856_thermocoupletype_t MAX31856::getThermocoupleType(void) {
	uint8_t t = readRegister8(MAX31856_CR1_REG);
	t &= 0x0F;

	return (max31856_thermocoupletype_t)(t);
}

/**************************************************************************/
/*!
@brief  Read the fault register (8 bits)
@returns 8 bits of fault register data
*/
/**************************************************************************/
uint8_t MAX31856::readFault(void) {
	return readRegister8(MAX31856_SR_REG);
}

/**************************************************************************/
/*!
@brief  Sets the threshold for internal chip temperature range
for fault detection. NOT the thermocouple temperature range!
@param  low Low (min) temperature, signed 8 bit so -128 to 127 degrees C
@param  high High (max) temperature, signed 8 bit so -128 to 127 degrees C
*/
/**************************************************************************/
void MAX31856::setColdJunctionFaultThreshholds(int8_t low, int8_t high) {
	writeRegister8(MAX31856_CJLF_REG, low);
	writeRegister8(MAX31856_CJHF_REG, high);
}

/**************************************************************************/
/*!
@brief  Sets the mains noise filter. Can be set to 50 or 60hz.
Defaults to 60hz. You need to call this if you live in a 50hz country.
@param  noiseFilter One of MAX31856_NOISE_FILTER_50HZ or MAX31856_NOISE_FILTER_60HZ
*/
/**************************************************************************/
void MAX31856::setNoiseFilter(max31856_noise_filter_t noiseFilter) {
	uint8_t t = readRegister8(MAX31856_CR0_REG);
	if(noiseFilter == MAX31856_NOISE_FILTER_50HZ) {
		t|=0x01;
		} else {
		t&=0xfe;
	}
	writeRegister8(MAX31856_CR0_REG, t);
}

/**************************************************************************/
/*!
@brief  Sets the threshhold for thermocouple temperature range
for fault detection. NOT the internal chip temperature range!
@param  flow Low (min) temperature, floating point
@param  fhigh High (max) temperature, floating point
*/
/**************************************************************************/
void MAX31856::setTempFaultThreshholds(float flow, float fhigh) {
	int16_t low, high;

	flow *= 16;
	low = flow;

	fhigh *= 16;
	high = fhigh;

	writeRegister8(MAX31856_LTHFTH_REG, high >> 8);
	writeRegister8(MAX31856_LTHFTL_REG, high);

	writeRegister8(MAX31856_LTLFTH_REG, low >> 8);
	writeRegister8(MAX31856_LTLFTL_REG, low);
}

/**************************************************************************/
/*!
@brief  Begin a one-shot (read temperature only upon request) measurement.
Value must be read later, not returned here!
*/
/**************************************************************************/
void MAX31856::oneShotTemperature(void) {
	writeRegister8(MAX31856_CJTO_REG, 0x0); //set offset at 0

	uint8_t t = readRegister8(MAX31856_CR0_REG);

	t &= ~(MAX31856_CR0_AUTOCONVERT); // turn off autoconvert!
	t |= (MAX31856_CR0_1SHOT);

	writeRegister8(MAX31856_CR0_REG, t);
}

/**************************************************************************/
/*!
@brief  Start a one-shot measurement and return internal chip temperature
@returns Floating point temperature of chip in Celsius
*/
/**************************************************************************/
float MAX31856::readCJTemperature(void) {
	
	int16_t temp16 = readRegister16(MAX31856_CJTH_REG);
	float tempfloat = temp16;
	tempfloat /= 256.0;

	return tempfloat;
}

/**************************************************************************/
/*!
@brief  Start a one-shot measurement and return thermocouple tip temperature
@returns Floating point temperature at end of thermocouple in Celsius
*/
/**************************************************************************/
float MAX31856::readThermocoupleTemperature(void) {

	int32_t temp24 = readRegister24(MAX31856_LTCBH_REG);
	if (temp24 & 0x800000) {
		temp24 |= 0xFF000000;  // fix sign
	}

	temp24 >>= 5;  // bottom 5 bits are unused

	float tempfloat = temp24;
	tempfloat *= 0.0078125;

	return tempfloat;
}

void MAX31856::setAveraging(uint8_t n)
{
	volatile uint8_t t;
	switch(n) //Avoid using log2
	{
		case 1: 
			n = 0 ;
			break;
		case 2:
			n = 1;
			break;
		case 4:
			n = 2;
			break;
		case 8:
			n = 3;
			break;
		case 16:
			n = 4;
			break;
		default:
			n = 0;
			break;
	}
	t = readRegister8(MAX31856_CR1_REG);
	t &= 0x8f; //clear bit 4 to 6
	t |=(n<<4); //Write the bit 4 to 6
	writeRegister8(MAX31856_CR1_REG, t);
	
}

/**********************************************/

MAX31856::MAX31856(){}; //private constructor because we don't want implicit constructor call

uint8_t MAX31856::readRegister8(uint8_t addr) {
	uint8_t ret = 0;
	readRegisterN(addr, &ret, 1);

	return ret;
}

uint16_t MAX31856::readRegister16(uint8_t addr) {
	uint8_t buffer[2] = {0, 0};
	readRegisterN(addr, buffer, 2);

	uint16_t ret = buffer[0];
	ret <<= 8;
	ret |=  buffer[1];
	
	return ret;
}

uint32_t MAX31856::readRegister24(uint8_t addr) {
	uint8_t buffer[3] = {0, 0, 0};
	readRegisterN(addr, buffer, 3);

	uint32_t ret = buffer[0];
	ret <<= 8;
	ret |=  buffer[1];
	ret <<= 8;
	ret |=  buffer[2];
	
	return ret;
}


void MAX31856::readRegisterN(uint8_t addr, uint8_t buffer[], uint8_t n) {
	addr &= 0x7F; // make sure top bit is not set

	setMux(_muxChannel);
	SPI.beginTransaction(max31856_spisettings);
	delayMicroseconds(20);

	SPI.transfer(addr);
	while (n--) {
		buffer[0] = SPI.transfer(0xFF);
		buffer++;
	}
	SPI.endTransaction();

	setMux(CS_DISABLE);
}


void MAX31856::writeRegister8(uint8_t addr, uint8_t data) {
	addr |= 0x80; // make sure top bit is set
	setMux(_muxChannel);
	SPI.beginTransaction(max31856_spisettings);
	delayMicroseconds(20);
	SPI.transfer(addr);
	SPI.transfer(data);
	SPI.endTransaction();
	setMux(CS_DISABLE);
}
