AnthonyPapageo/Datalogger/measure.h

/*
 * measure.h
 *
 * Created: 29/04/2019 08:47:59
 *  Author: Anthony
 */ 

#ifndef MEASURE_H_
#define MEASURE_H_

void initSensors(void);
void computeTime(void);
void getAllMeasures(void);
void getNTCMeasures(void);
void getV24Measures(void);
void getV5Measures(void);
void getIMeasures(void);




#endif /* MEASURE_H_ */
