AnthonyPapageo/Datalogger/utility.h

#ifndef UTILITY_H
#define UTILITY_H


#include <Pushbutton.h>


//////////////PROTOTYPE//////////////
void initMux(void);
void setMux(const uint8_t value);
void initRTC(void);
void enableVref(bool b);
bool IsSdInserted(void);
void saveToEEPROM(void);
void LoadFromEEPROM(void);
void buttonsCheck(void);
void buttonsCheck(Pushbutton& back, Pushbutton& left , Pushbutton& down, Pushbutton& up,Pushbutton& right, Pushbutton& Ok);
void initInterruptTimer(void);
void stopTimer(void);
void resetToDefault(void);
void setFileName(void);
void firstLineSD(void);
void saveToSD(void);
void led_SD(bool b);
void emptyfunction(void);



#endif
