AnthonyPapageo/Datalogger/(commit log)

2019-05-07 Todo back button
2019-05-13 ISR timer
2019-05-17 correction bug ADC
2019-05-21 SD correction and SD for proto
    [ADC.cpp, MAX31856.cpp, global.cpp, measure.cpp, menu.cpp, utility.cpp, utility.h]
2019-06-06 Add measures
    [13H23.xlsx, 14H43.xlsx, 18H28.xlsx, Etuve.xlsx]
2019-06-06 Add Eagle
    [DataloggerE7.brd, DataloggerE7.sch]
