AnthonyPapageo/Datalogger/(notices)

Notices in the files:
parts and their libraries:
FaBo-Mems: Released under the Creative Commons Attribution-ShareAlike 4.0 License
https://creativecommons.org/licenses/by-sa/4.0
SparkFun-PowerSymbols: Licensing: Creative Commons ShareAlike 4.0 International - https://creativecommons.org/licenses/by-sa/4.0
